LaserRackBoards/rf_amp_opa818/README.md

# rf_amp_opa818
Triple general purpose rf amplifier board based on OPA818 with BUF602 output-buffer.

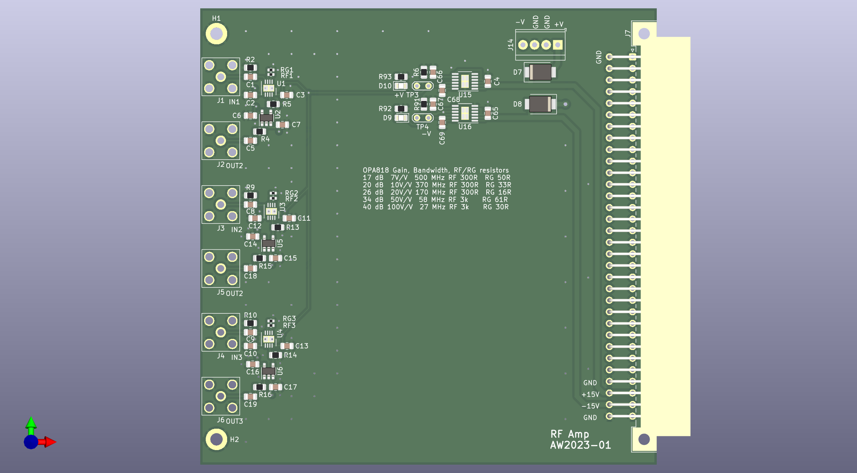
[picture p1: rf_amp_pcb.png]


Predicted gain and bandwith from OPA818 datasheet:

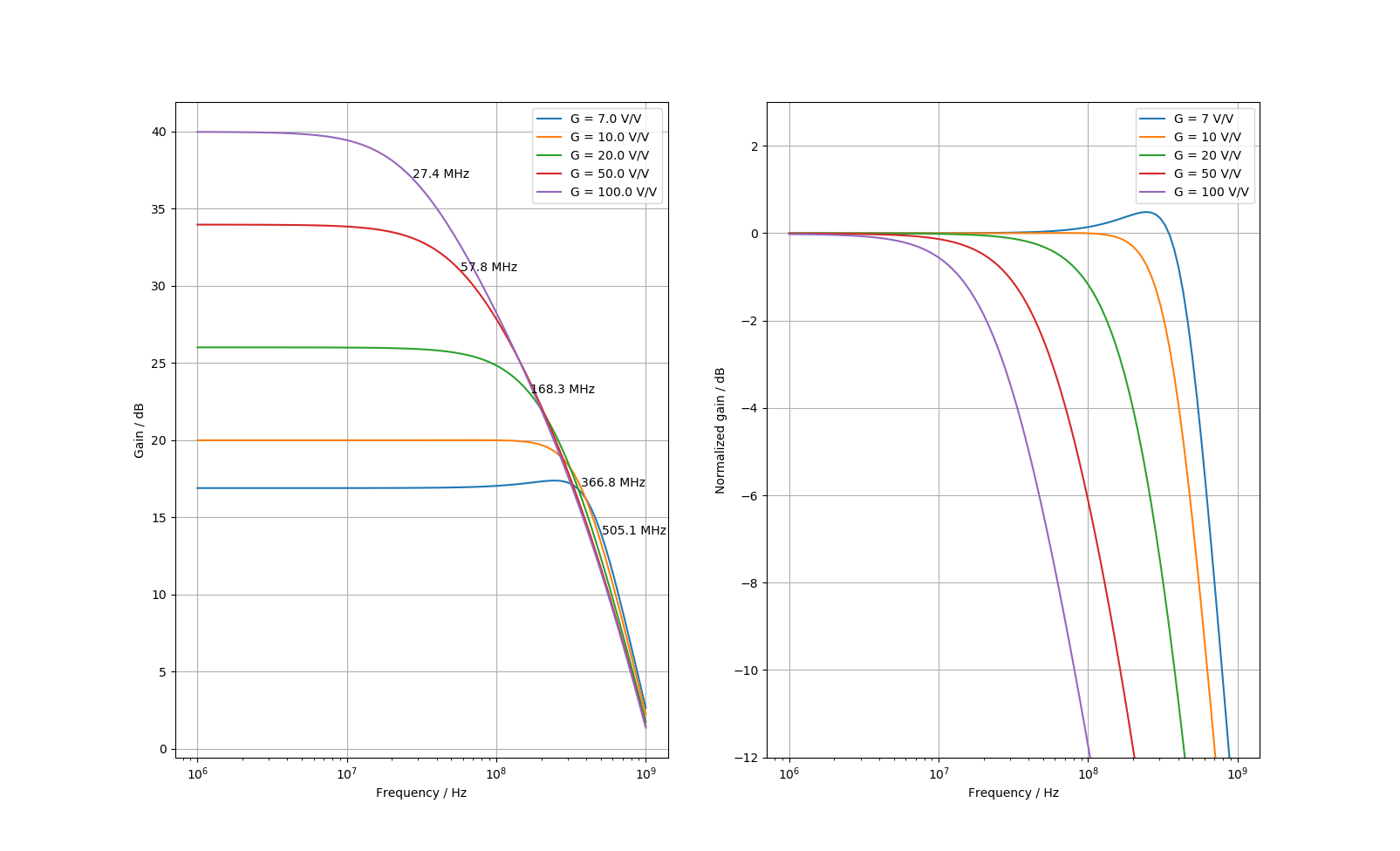
[picture p2: OPA818_gain.png]
