LaserRackBoards/rf_amp_opa818/amp.kicad_pcb

## KiCad design amp.kicad_pcb (2025-11-21)

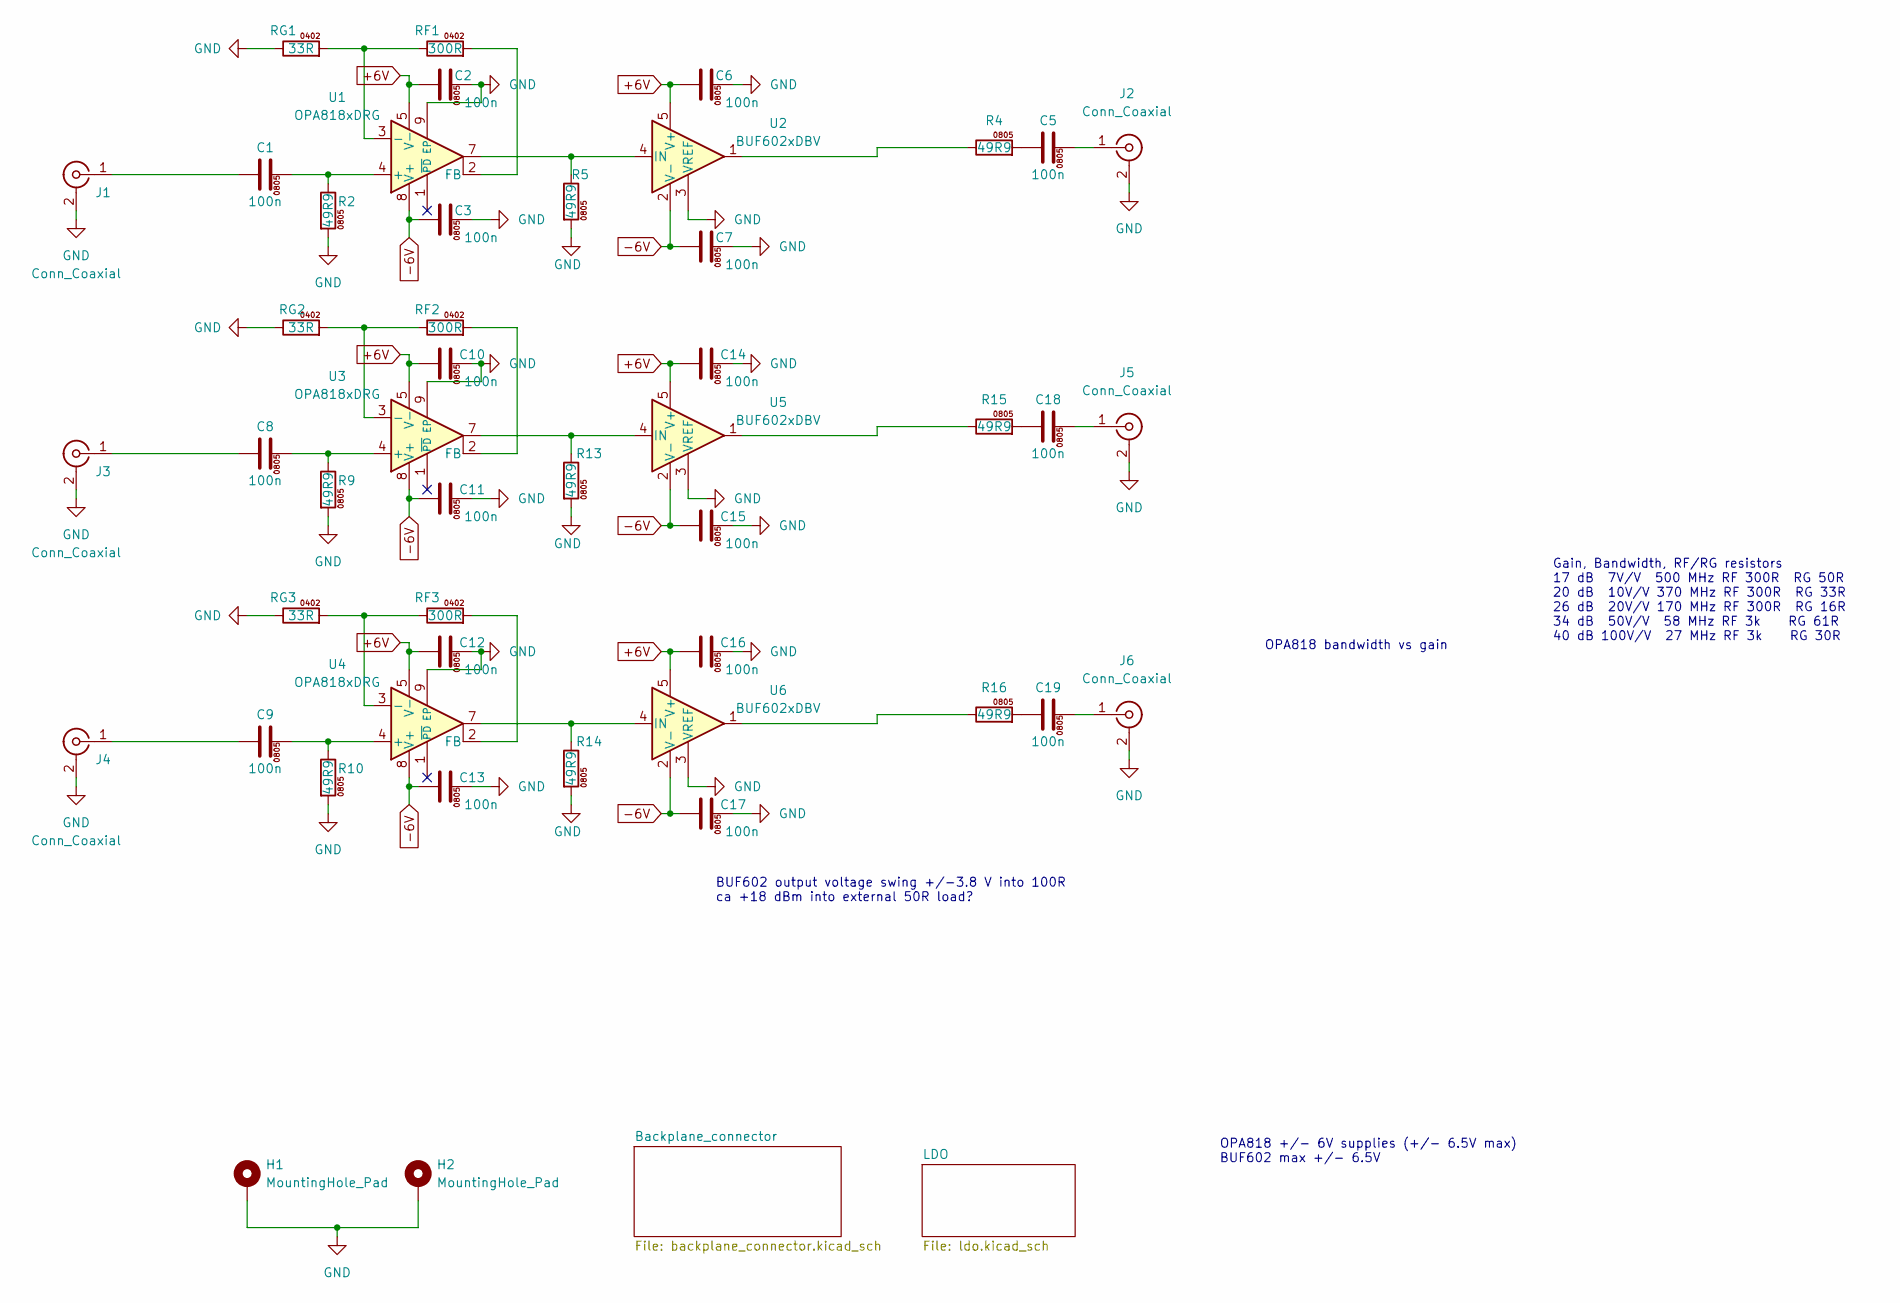
[picture p3: schematic amp.kicad_sch, RF Amplifier]

Parts:
C1, C2, C3, C5, C6, C7, C8, C9, C10, C11, C12, C13, C14, C15, C16, C17, C18, C19: 100n; C_0805_2012Metric
H1, H2: MountingHole_Pad; MountingHole_2.7mm_M2.5_DIN965_Pad
J1, J2, J3, J4, J5, J6: Conn_Coaxial; SMA_Amphenol_132203-12_Horizontal
R2, R4, R5, R9, R10, R13, R14, R15, R16: 49R9; R_0805_2012Metric
RF1, RF2, RF3: 300R; R_0402_1005Metric
RG1, RG2, RG3: 33R; R_0402_1005Metric
U1, U3, U4: OPA818xDRG; WSON-8-1EP_3x3mm_P0.5mm_EP1.45x2.4mm
U2, U5, U6: BUF602xDBV; SOT-23-5

Connections:
GND: C2.2, C3.2, C6.2, C7.2, C10.2, C11.2, C12.2, C13.2, C14.2, C15.2, C16.2, C17.2, H1.1, H2.1, J1.2 (Ext), J2.2 (Ext), J3.2 (Ext), J4.2 (Ext), J5.2 (Ext), J6.2 (Ext), R2.2, R5.2, R9.2, R10.2, R13.2, R14.2, RG1.1, RG2.1, RG3.1, U1.9 (EP), U2.3 (VREF), U3.9 (EP), U4.9 (EP), U5.3 (VREF), U6.3 (VREF); also elsewhere on the board
unnamed: C1.1, J1.1 (In)
unnamed: C1.2, R2.1, U1.4 (+)
unnamed: C5.1, R4.2
unnamed: C5.2, J2.1 (In)
unnamed: C8.1, J3.1 (In)
unnamed: C8.2, R9.1, U3.4 (+)
unnamed: C9.1, J4.1 (In)
unnamed: C9.2, R10.1, U4.4 (+)
unnamed: C18.1, R15.2
unnamed: C18.2, J5.1 (In)
unnamed: C19.1, R16.2
unnamed: C19.2, J6.1 (In)
unnamed: R4.1, U2.1
unnamed: R5.1, U1.7, U2.4 (IN)
unnamed: R13.1, U3.7, U5.4 (IN)
unnamed: R14.1, U4.7, U6.4 (IN)
unnamed: R15.1, U5.1
unnamed: R16.1, U6.1
unnamed: RF1.2, U1.2 (FB)
unnamed: RF2.1, RG2.2, U3.3 (-)
unnamed: RF2.2, U3.2 (FB)
unnamed: RF3.1, RG3.2, U4.3 (-)
unnamed: RF3.2, U4.2 (FB)
unnamed: RF1.1, RG1.2, U1.3 (-)

Notes on the sheet:
OPA818 bandwidth vs gain
OPA818 +/- 6V supplies (+/- 6.5V max) BUF602 max +/- 6.5V
Gain, Bandwidth, RF/RG resistors 17 dB 7V/V 500 MHz RF 300R RG 50R 20 dB 10V/V 370 MHz RF 300R RG 33R 26 dB 20V/V 170 MHz RF 300R RG 16R 34 dB 50V/V 58 MHz RF 3k RG 61R 40 dB 100V/V 27 MHz RF 3k RG 30R
BUF602 output voltage swing +/-3.8 V into 100R ca +18 dBm into external 50R load?

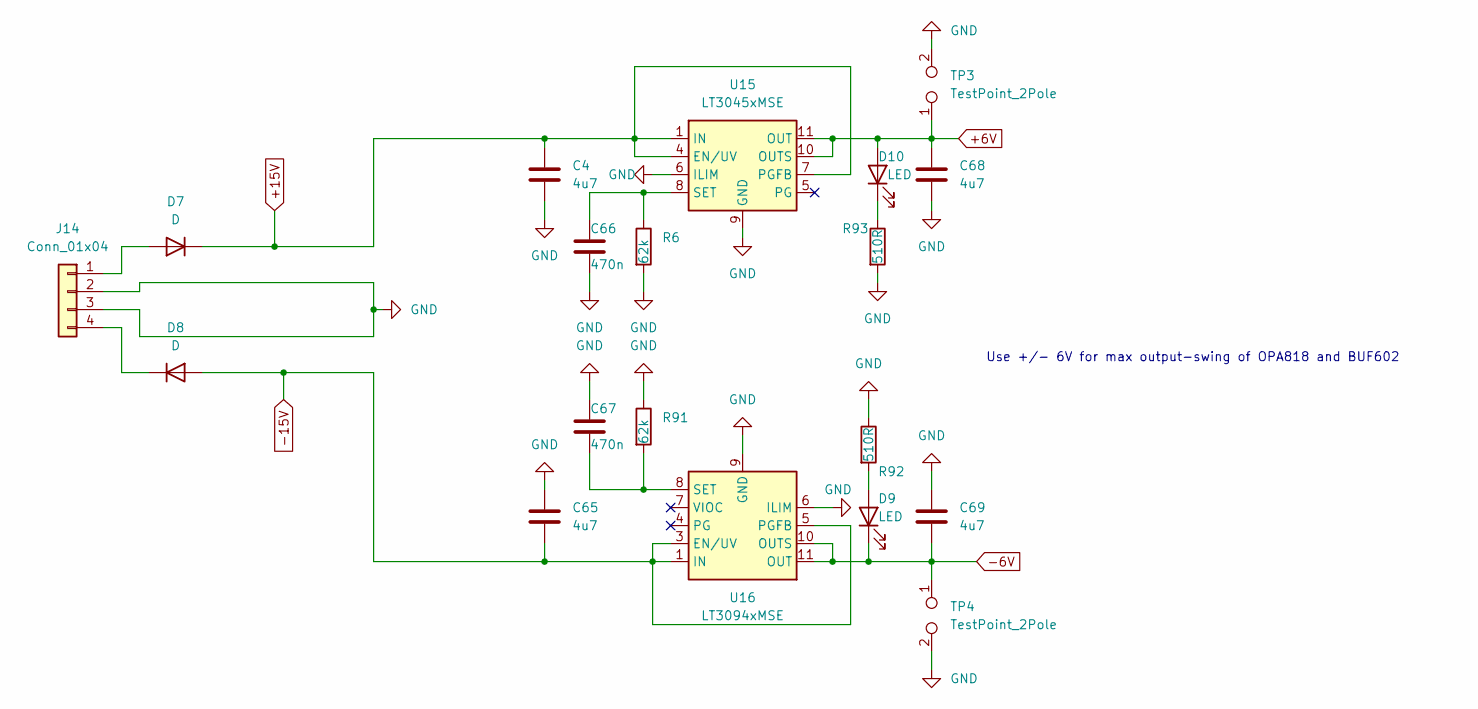
[picture p4: schematic ldo.kicad_sch]

Parts:
C4, C65, C68, C69: 4u7; C_0805_2012Metric
C66, C67: 470n; C_0805_2012Metric
D7, D8: D; D_SMB
D9, D10: LED; LED_0805_2012Metric
J14: Conn_01x04; TerminalBlock_TE_282834-4_1x04_P2.54mm_Horizontal
R6, R91: 62k; R_0805_2012Metric
R92, R93: 510R; R_0805_2012Metric
TP3, TP4: TestPoint_2Pole; TestPoint_2Pads_Pitch2.54mm_Drill0.8mm
U15: LT3045xMSE; MSOP-12-1EP_3x4mm_P0.65mm_EP1.65x2.85mm
U16: LT3094xMSE; MSOP-12-1EP_3x4mm_P0.65mm_EP1.65x2.85mm

Connections:
+15V: C4.1, D7.1 (K), U15.1 (IN), U15.2 (IN), U15.3 (IN), U15.4 (EN/UV), U15.7 (PGFB); also elsewhere on the board
-15V: C65.2, D8.2 (A), U16.1 (IN), U16.2 (IN), U16.3 (EN/UV), U16.5 (PGFB), U16.13 (IN); also elsewhere on the board
GND: C4.2, C65.1, C66.2, C67.1, C68.2, C69.1, J14.2, J14.3, R6.2, R91.1, R92.1, R93.2, TP3.2, TP4.2, U15.6 (ILIM), U15.9 (GND), U15.13 (GND), U16.6 (ILIM), U16.9 (GND); also elsewhere on the board
unnamed: C66.1, R6.1, U15.8 (SET)
unnamed: C67.2, R91.2, U16.8 (SET)
unnamed: D7.2 (A), J14.1
unnamed: D8.1 (K), J14.4
unnamed: D9.2 (A), R92.2
unnamed: D10.1 (K), R93.1

Notes on the sheet:
Use +/- 6V for max output-swing of OPA818 and BUF602

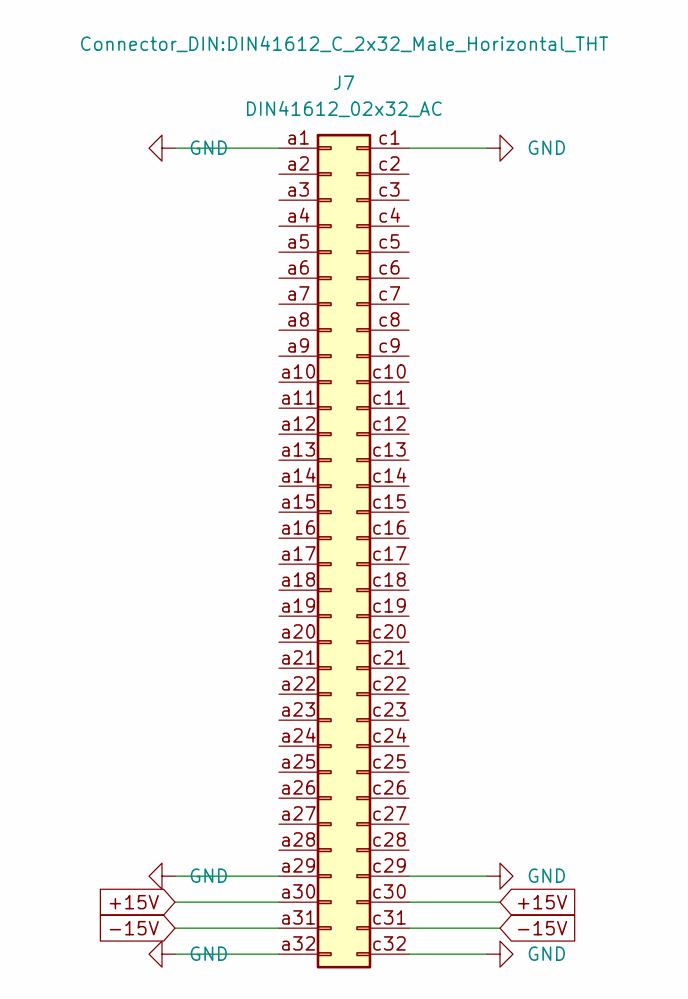
[picture p5: schematic backplane_connector.kicad_sch, OLARS backplane connector]

Parts:
J7: DIN41612_02x32_AC; DIN41612_C_2x32_Male_Horizontal_THT

Connections:
+15V: J7.a30, J7.c30; also elsewhere on the board
-15V: J7.a31, J7.c31; also elsewhere on the board
GND: J7.a1, J7.a29, J7.a32, J7.c1, J7.c29, J7.c32; also elsewhere on the board

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
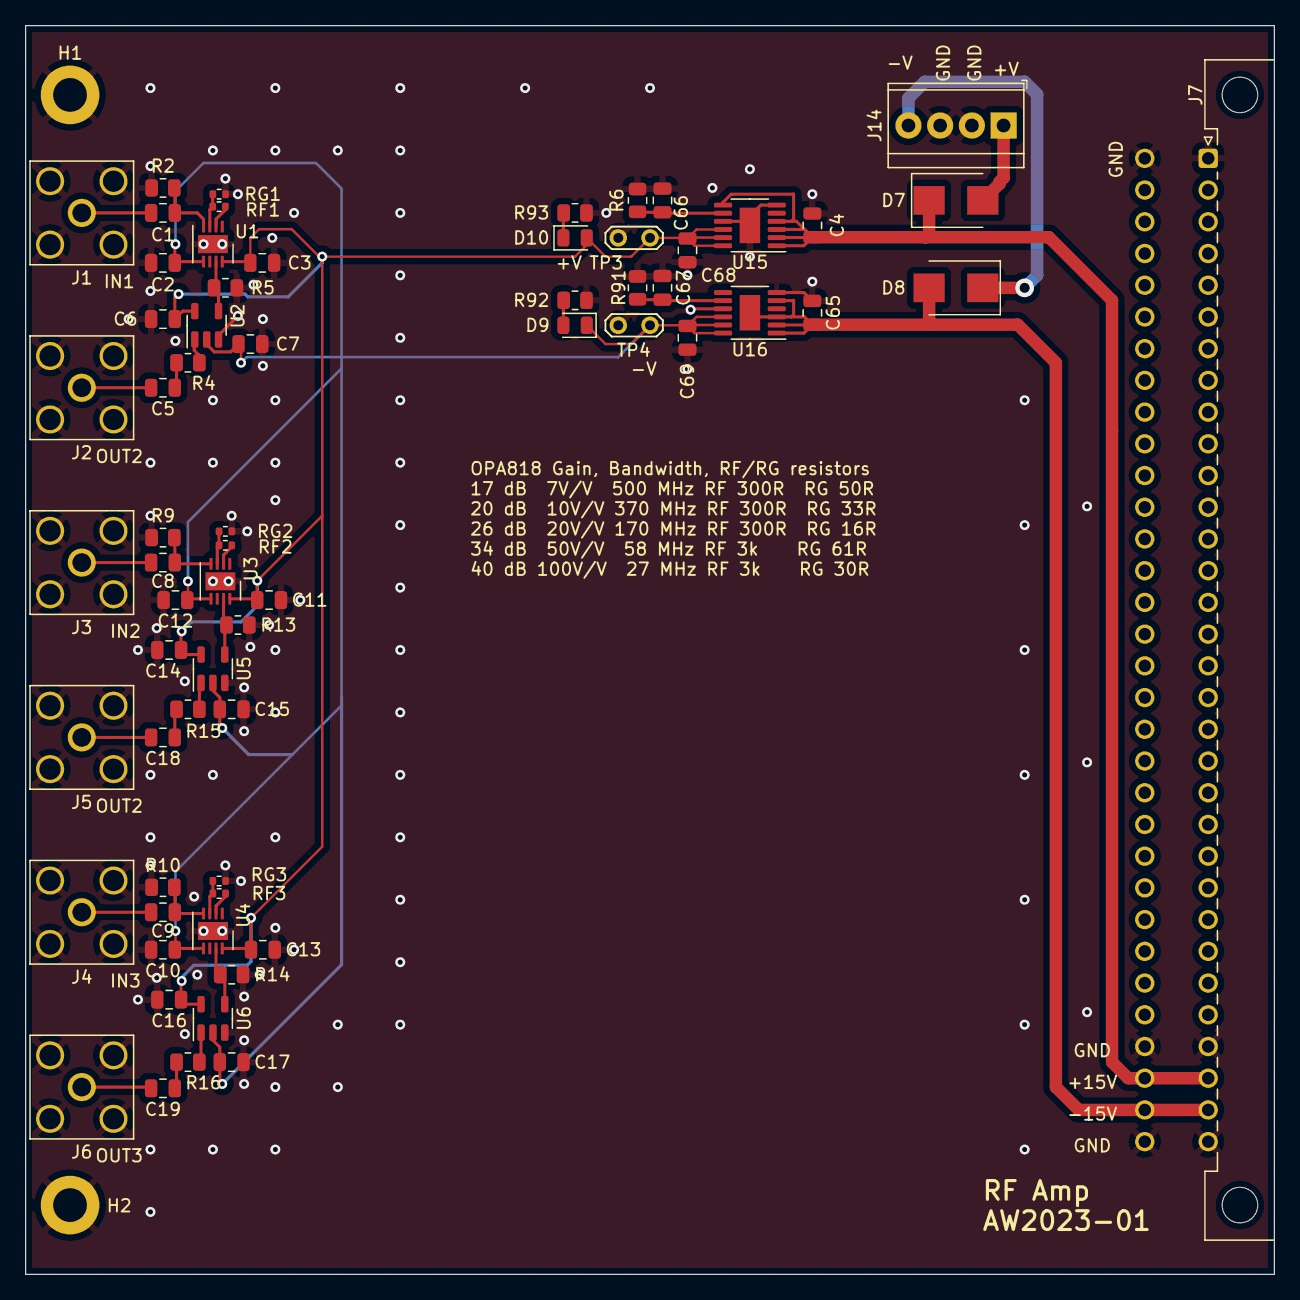
[picture p6: board amp.kicad_pcb from above]

Board: 2 copper layers, 100.0 x 100.0 mm, 67 parts (0 on the bottom side), 35 nets.
